namor5772/WeatherStation/Arduino/ARDUINO.md

# Arduino setup

## Hardware

Arduino Leonardo

## Software
