namor5772/WeatherStation/data/WeatherStation.png

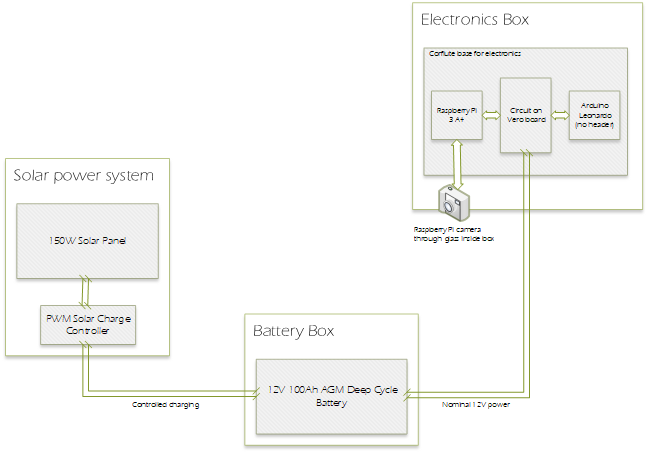
data/WeatherStation.png
