namor5772/WeatherStation/images/BindaPhoto1.jpg

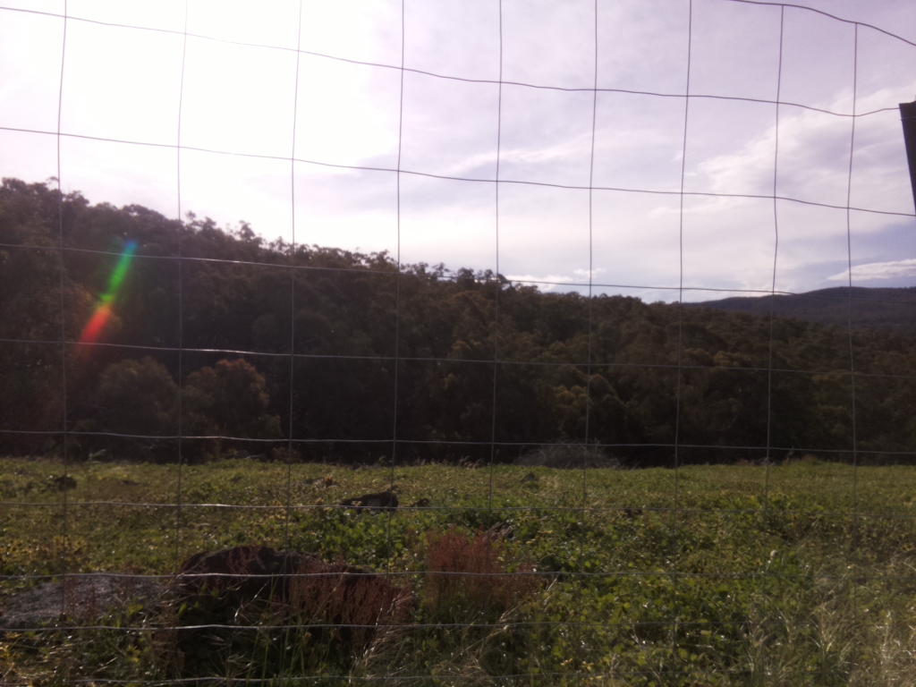
images/BindaPhoto1.jpg
