namor5772/WeatherStation/images/BindaWeatherMain1.png

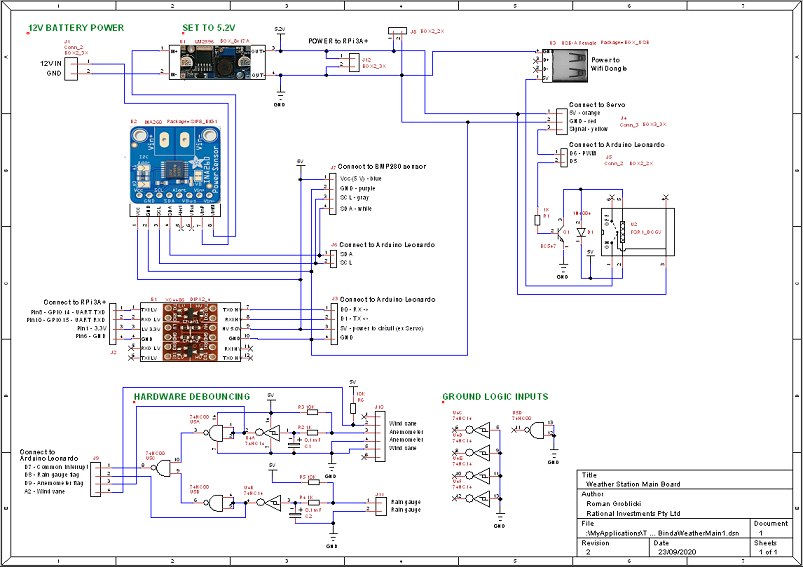
images/BindaWeatherMain1.png
