namor5772/WeatherStation/images/BindaWeatherMain1c.png

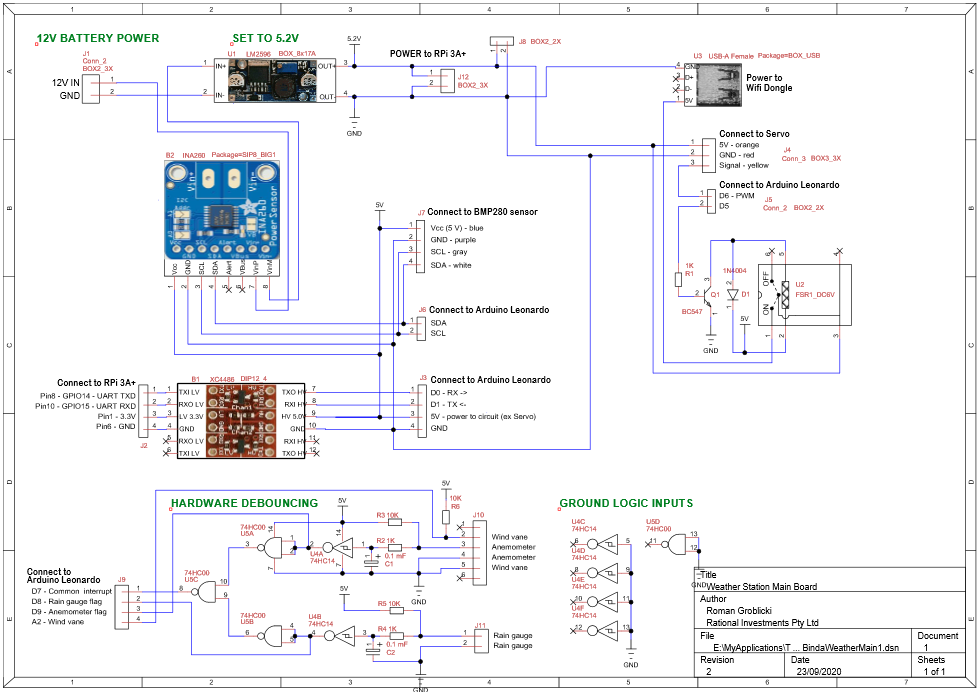
images/BindaWeatherMain1c.png
