namor5772/WeatherStation/images/photo2.jpg

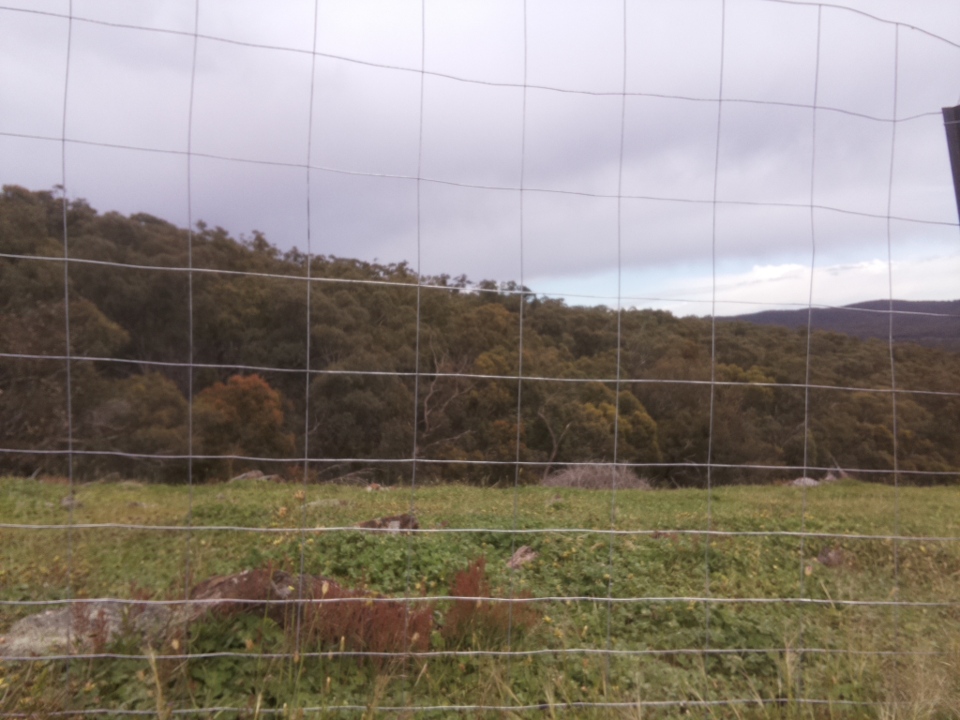
images/photo2.jpg
