namor5772/WeatherStation/images/photo.jpg

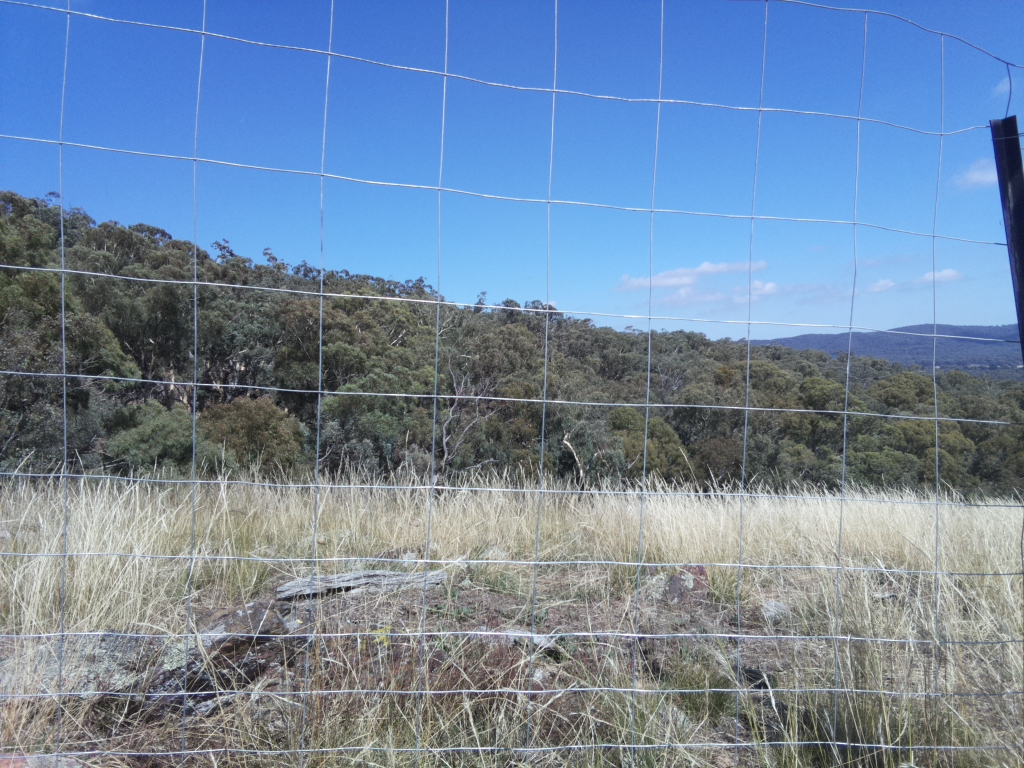
images/photo.jpg
