namor5772/WeatherStation/images/WeatherBox.jpg

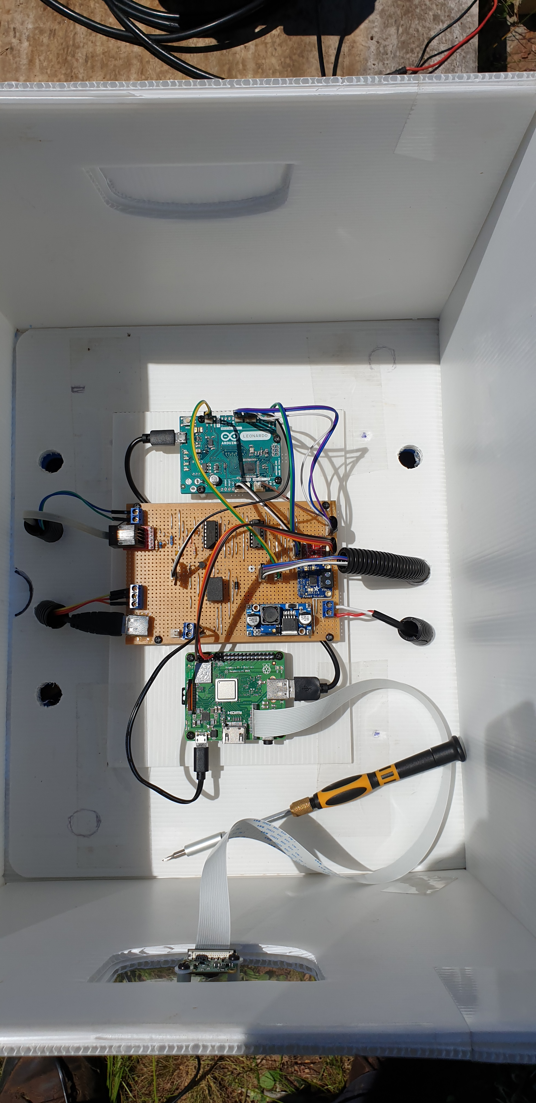
images/WeatherBox.jpg
