namor5772/WeatherStation/images/WeatherStation.png

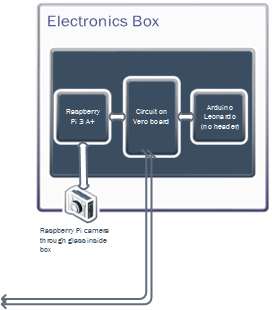
images/WeatherStation.png
