namor5772/WeatherStation/images/ws1.png

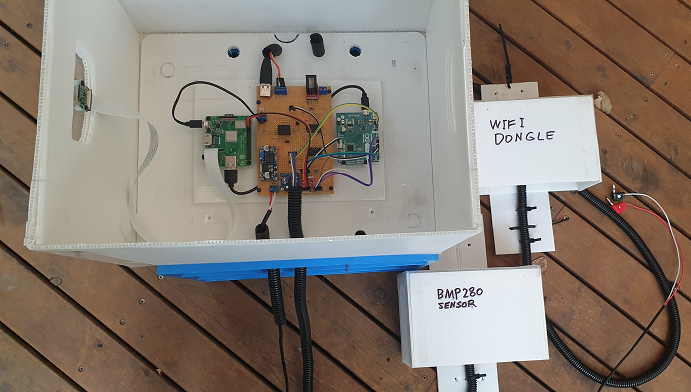
images/ws1.png
