namor5772/WeatherStation/(list of files, drawings)

Other design files:
data/BindaWeatherMain1.dsn
data/WeatherStationMain1.dsn
