namor5772/WeatherStation/(commit log)

2020-09-27 Setup Arduino directories better
2020-09-29 RPI files
    Raspberry Pi files added
2020-10-07 as CAD related
    [BindaWeatherMain1.dsn]
2020-10-07 TinyCAD additions
    [BindaWeatherMain1.dsn]
2020-10-20 update
    update
    [BindaWeatherMain1.dsn]
